durfeeke1/team33ME210Project/Report/index.html

# TEAM 33

# Team Name: 0 - 2 (Real Quick) ME210 Winter

## Project Overview

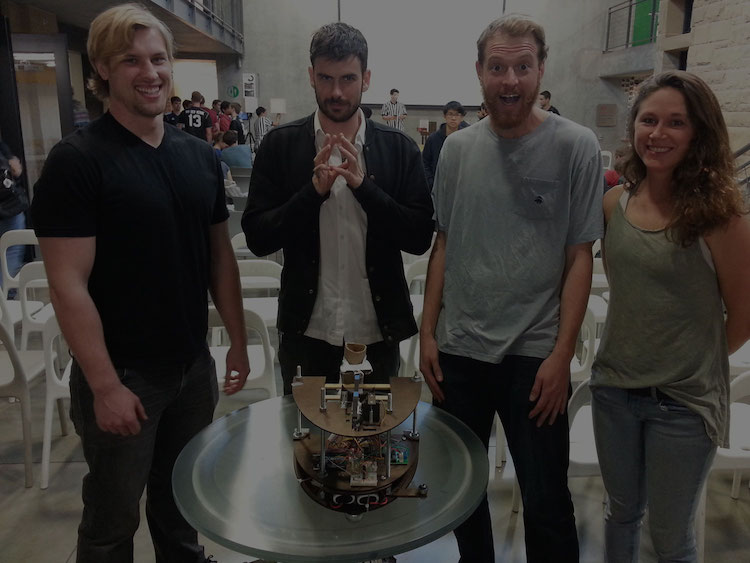
[picture p1: Report/img/teamPhoto.jpg]


Team Members: Kevin Durfee, Carey Smith, Ryan Wolff, Maria Malone

As the ME 210 Robot Project sat on our Winter Quarter horizon, Team 0 to 2 (Real Quick) pondered our overall strategy. While we wanted to put 100% effort into the project, we also valued our health and other classes. We deemed ourselves to be a “Shallow Grave” group – we wanted to do enough work to check off and learn a lot, but weren’t preparing ourselves to win the competition.

When the project was assigned we decided early on that we would not do beacon sensing, and instead we chose to use the tape on the board to align ourselves with the 1 point basket on our side of the court.

Here is our story.

## DrizzyBot / Cheff Curry - Sub Systems

### Bill Of Materials

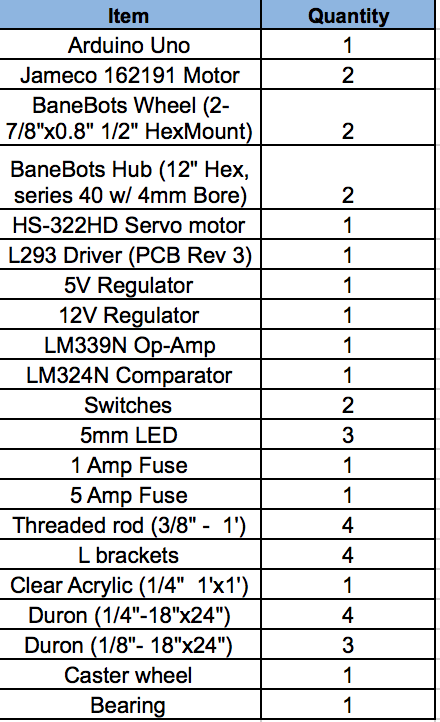
[picture p2: Report/img/BOM2.png]


## Mechanical Design

### Overall Chassis Design

We chose a body shape that we thought would be ideal to keep us out of corners yet still align us square on the wall behind us. However the radius of the nose of the body did render us useless in some corners when starting from certain positions on the court. A square bot, though, would not have kept us from getting stuck in corners either. Overall bot design could have been improved with a circular bot base. Implementing alignment bumpers similar to the ones currently on Drizzy Bot/Chef Curry would have still allowed a circular design to accurately line and square up on the wall.

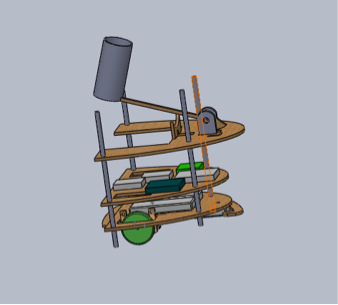
[picture p3: Report/img/cadSideView.png]


### Drive Train

The secure mounting of our motor to both the body of the bot and the wheels was crucial in order to get a reliable driving bot that wasn’t unstable or weak. Initially, we used two similar motor mounts on each side, each of which cradled the motor to keep it from falling. These two mounts were then fixed a distance apart using bolts and nuts. However, because it was difficult to get the precise tolerance in the motor mounts, there was just enough “slop” and freedom for the motors to move and shift within the mount. We then decided it would be best to create just one motor mount for each side, which bolted into the face of the motor and was then secured to the base of the bot through an L-bracket. This was a reliable method for motor stabilization, albeit not the most intricate or aesthetically pleasing. However, because it was a method that worked well, we decided to move forward with the construction of the rest of our bot.

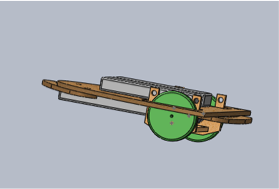
[picture p4: Report/img/cadBase.png]


### Tape Sensors

The mechanical design of our tape sensor setup was crucial to the successful functioning of the system as a whole. If the spacing of the sensors was slightly off, the accuracy of both tape sensing and following would be lower than it potentially could be. When using tape sensors, the spacing is crucial but so is the position of the tape sensors relative to the board. Because the tape sensors easily could pick up ambient light, the ideal height of the tip of the sensors was 1mm-4mm above the board. Additionally, the tip of the sensors needed to be as parallel to the board as possible. Because different times of day and conditions could easily affect the reading of the tape sensors, we wanted to have the freedom and ability to adjust the positioning of each tape sensor and the sensor platform as a whole. Therefore each sensor was mounted to its own individual backplate, which itself was secured to the tape sensor platform. The screw which attached each tape sensor to the backplate allowed for individual tape sensor height adjustment fairly easily. (Each tape sensor has an optimally sized slot for a 4-40 screw to be used for mounting). The platform height was adjustable using a double nut design. If tape sensors are used, we highly suggest using some sort of adjustable design, similar to what we used. This allows for fine-tuning of the physical tape sensing system for optimal readings and response.

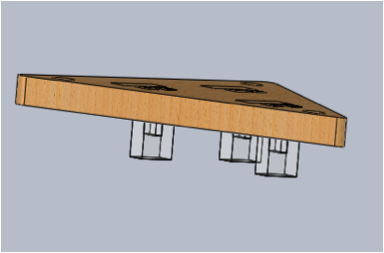
[picture p5: Report/img/cadTapeSide.png]
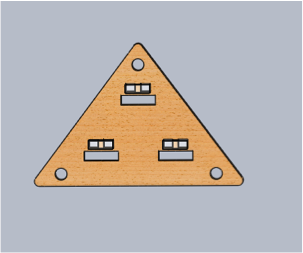
[picture p6: Report/img/cadTapeTop.png]
 

### Shooting Mechanism

Initially we couldn’t settle on an approach for scoring points. So we wavered between doing a shooter and dunker for a while. Because we lost a lot of time in limbo between the two, we decided that the most efficient use of our time was to implement a dunker in order check off. Our thoughts were to then perfect it when/if we had time. Because we worked to check off early, we used a dunk mechanism that ended up completing the challenge, yet was a visual eye sore. Our initial more intricate design implementing a natural hinge ended up being too heavy. While we liked the look and experiment with design much more, we knew that a more simple and light solution was needed to not overstress our servo motor.

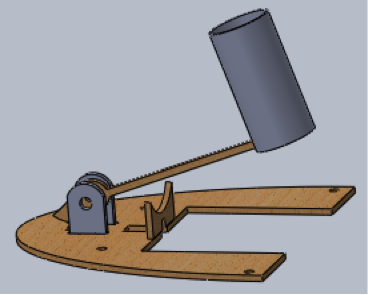
[picture p7: Report/img/cadTopLayer.png]


## Electrical Design

We broke the electrical system down into a few different circuits that were linked together.
Power Supply, Drive Train, Tape sensing, shooter mechanism

Generally our circuits were pretty solid. The biggest issue we encountered was when we swapped chasis. We had used the double sided tape on the bread boards to fix them to the first bot. When we removed them the tape completely destroyed our circuits!!! DON'T DO THAT.

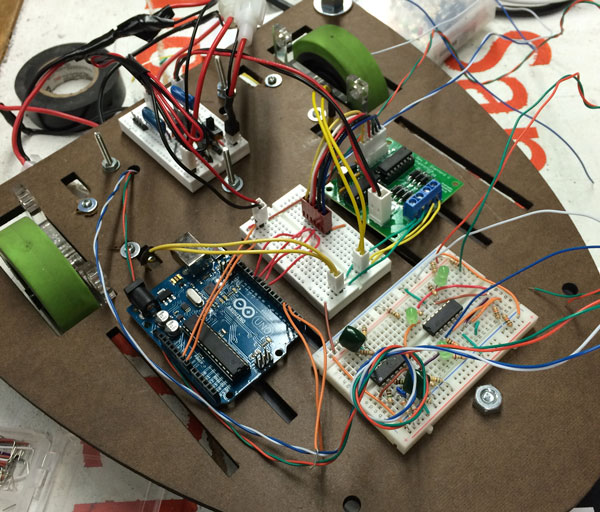
[picture p8: Report/img/circuits.JPG]


a photo of our circuits on the bot

### Schematics

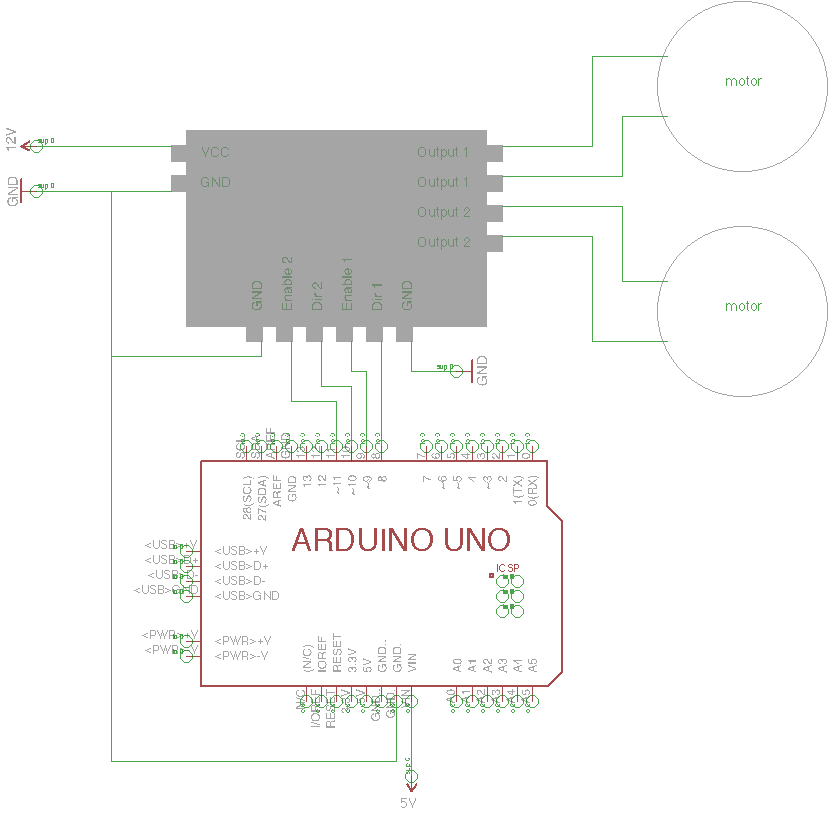
[picture p9: Report/img/DrivetrainSch.png]


drivetrain schematic

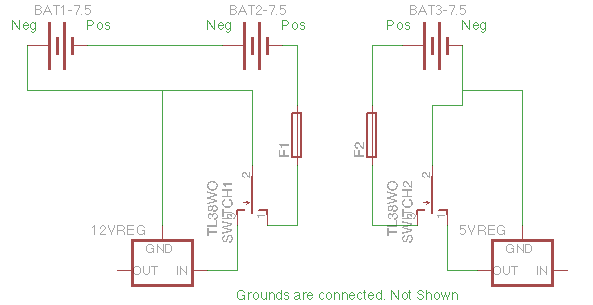
[picture p10: Report/img/PowerSch.png]


power supply schematic

## Tape Sensing

In our original design we attempted to create a digital input to the Arduino from each tape sensor. This design had three components to it.

First, we tied the anode of the photodiode to 5V and placed an 130 ohm resistor between its cathode and ground. This was done to ensure that the current going through the photodiode was large enough to be detected by the phototransistor but also not large enough to damage the component.

Equation 1: (Vdd-Vf)< 40ma => (5V-0V)/40ma < R => R > 125 ohms

Equation 2: (Vdd-Vf)> 20ma => (5V-1.7V)/20ma > R => R < 165 ohms

Second, we used an op-amp to amplify the signal. Here the positive input of the op-amp is tied to another op-amp that is generating a stable 2.5V. Using our ideal op-amp model this means that the op-amp will work as hard as it can to keep the negative input at 2.5V. As a result there is always a (5V-2.5V) = 2.5V drop across the phototransistor, which satisfies the forward voltage drop required for it to function properly. Since the current from the phototransistor cannot pass through the op-amp it can only travel through the resistor that connects the output to the negative input. As a result there is a voltage drop from the negative input to the output that is equal to the current from the photodiode multiplied by the resistor. Therefore our equation describing the output voltage as a function of the photodiode current is as follows:

Equation 3: Vo - V- = -IR => Vo = V- -IR => Vo = 2.5V - IR

We saw the voltage range from 2-2.5 when the tape sensor was about a quarter inch from the tape to .5 when the tape sensor was a quarter inch from the white board. We also tied an LED to the output of this stage, to give us visual confirmation that the circuit was generating the expected result. We used similar calculations to the ones used in stage 1 to determine that a 75 ohm resistor was required to limit the current through the diode. THIS WAS EXTREMELY HELPFUL! If you can use LED's to indicate what is happening in your circuits it makes it much easier to figure out what is going wrong while you are debugging.

The final stage of the circuit was meant to convert the signal from the op-amp to a logical 1 or 0 for the Arduino using a comparator with hysteresis. We eventually ended up dropping this stage of the circuit in our final design and used analoge input pins to read the output signal from the op-amp stage directly. This was done for a few reasons. First, the Arduino Uno only has 2 pins that can be configured to generate interrupts on rising or falling signals. Since our design uses 3 tape sensors, we couldn't take advantage of the speedy response time that interrupts offer. Second, the amount of ambient light in the lab changed the output of the op-amp stage enough that it was difficult to get the comparator stage to accurately determine if it should generate a 1 or 0. This could have been avoided if we had used an oscillator to generate the signal from our photodiode and then filtered out any signal from ambient light. In the end we decided the easiest thing to do would just be to handle the hysteresis and logic level conversion in software. I would recommend this to anyone. You only have two weeks and changing or debugging software is much easier than changing and debugging hardware.

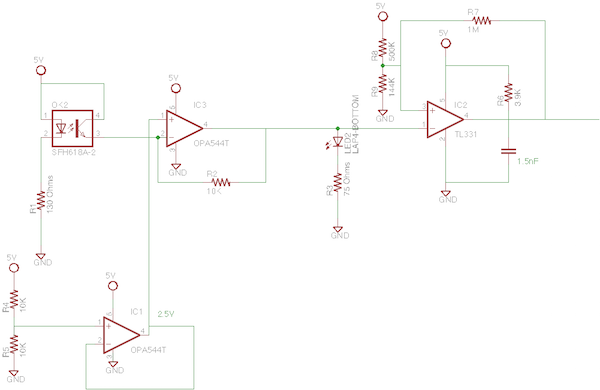
[picture p11: Report/img/firstTapeSensingCircuit.png]


Original Tape Sensing Circuit Design

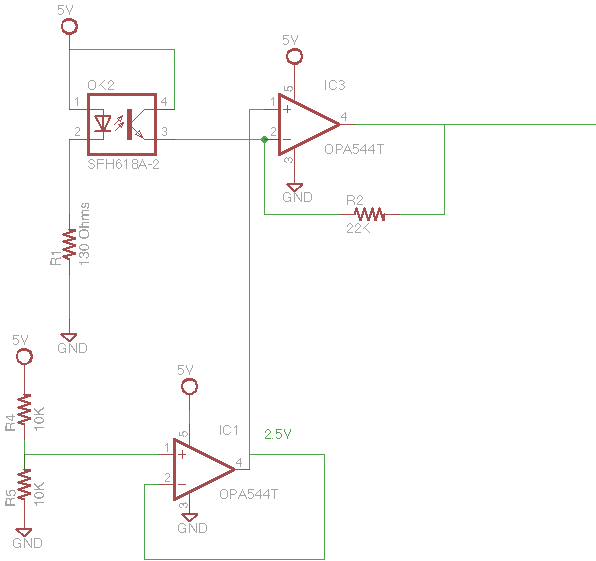
[picture p12: Report/img/finalTapeSensingCircuit.png]


Final Tape Sensing Circuit Design

## Software Design

Our software design can be broken down into a two levels. The first is the global state machine and the second is comprised of a mini state machine for each global state. This design is helpful because it segments the mini state machines from each other, making them easier to develop and debug independently. It also made it easy to loop the global state machine in order to make multiple passes at the hoop.

### Global State Machine

- Get Balls - used to bump the edge of the board and wait for balls to be loaded
- Align To Drive Straight - used to position the robot to follow the left wall to the end of the board
- Drive Straight - used to send the robot to the end of the board
- Tape Sensing - used to find the tape in front of the hoop and make a 90 degree turn
- Dunking - used to raise the servo and drop the balls in the hoop

### Sub State Machines:

Each of the sub state machines was implemented as a single function with a static variable used to keep track of the current state. I would recommend this as it hides the sub state machines state from the rest of the code. When the sub state machine has accomplished it's task it then changed the global state to move on to the next sub state machine.

## What we learned

We executed our plan but made changes along the way, the best practice we can recommend is to anticipate and prepare for unknown changes. The best way to do this is designing for testing. Build your components to be sturdy but flexible and provide feedback. The first mount for our tape sensors allowed us to adjust the distance between them. It was quick, flexible and we could immediately change the arrangement based on observations we wouldn’t have predicted.

Our tape sensors were arranged close together on the underside of the bot and very difficult to see which sensor was over tape at any time. We integrated LEDs into our tape sensing circuit that indicated when each tape sensor was reading Hi at any given moment. This helped in most cases but as we progressed our states were dependent the previous tape sensor reading as well as the most recent. To solve this issue, we arranged the arduino to allow for “tethered” testing. The serial monitor displayed which state our bot was in and anytime the sensors changed. With this information could determine the exact path the bot and sensors took over the tape and how to correct it. We designed and built many of the components in parallel but upon integration ran into multiple problems (Here’s a tip - using the Servo library disables the PWM functionality of pins 9 & 10, so don’t use them to run your motors). Swapping chassis also changed the weight distribution, negating the time spent calibrating the motors on the first version.

The language and naming conventions should also be made clear early on. Things can get confusing when you start turning, moving in reverse, increase the power of the right motor to turn left, etc. Like in theatre, they have a convention of stage right/left, discuss the behavior of your bot in a consistent manner and comment your code accordingly.

Remember to step back and look at how everything works together. There are many solutions to every problem. If you are having trouble getting results with an electrical component like the tape sensors, think about a software or mechanical solution. You could change the hysteresis or change where they are mounted or you could change another part of the bot entirely. We modified the shape of our bot and used its geometry to orient ourselves perpendicular to the walls. This allowed for a consistent approach angle to the tape which was crucial for our alignment with the basket. Don’t underestimate the physical world! Cut out a model of your bot and walk it around the game board, walk it around, take it through your states step by step.
