durfeeke1/team33ME210Project/Report/img/BotCollage.jpg

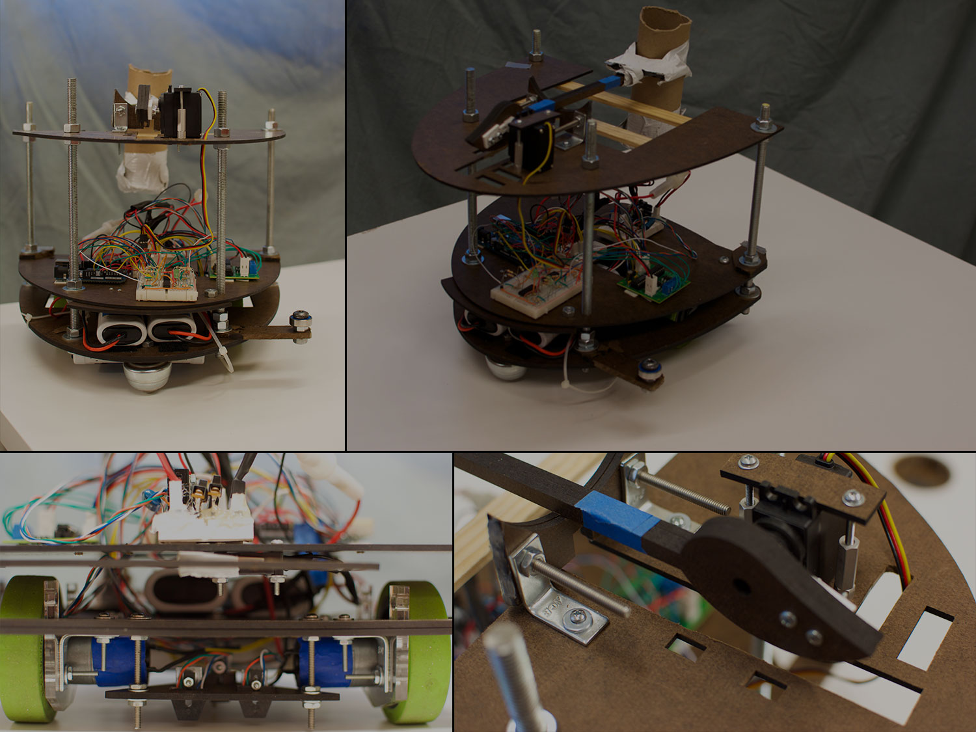
Report/img/BotCollage.jpg
