durfeeke1/team33ME210Project/Report/img/Hammer.png

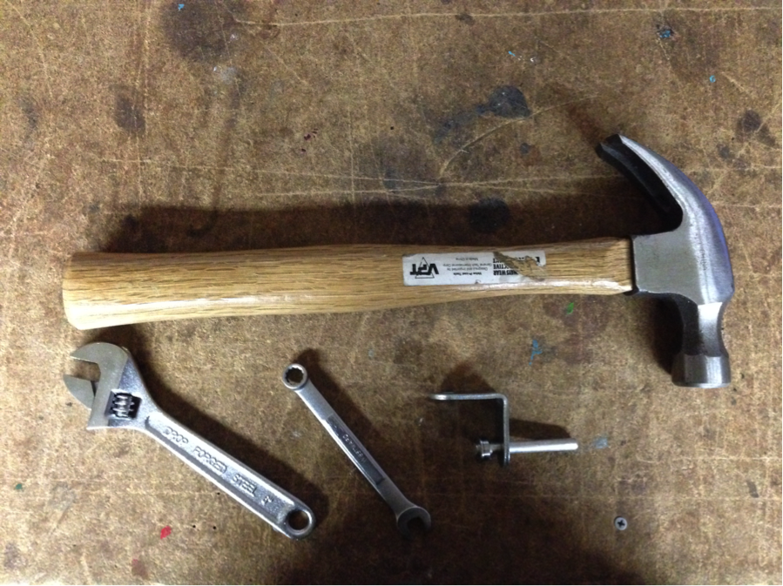
Report/img/Hammer.png
