durfeeke1/team33ME210Project/Report/img/BOM.png

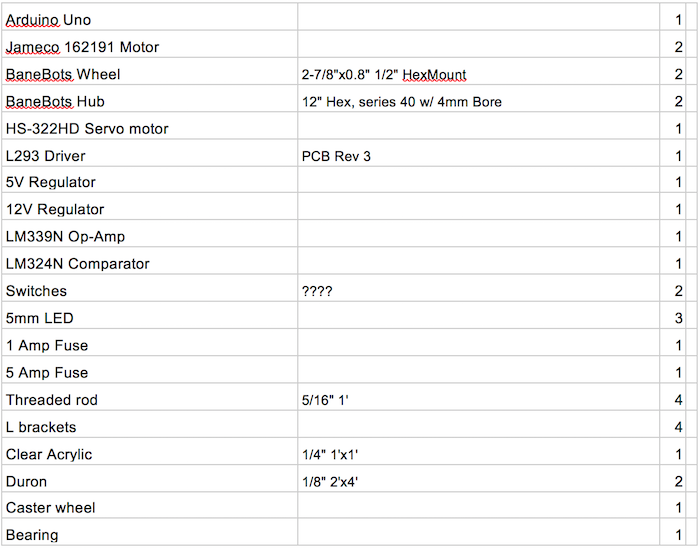
Report/img/BOM.png
