durfeeke1/team33ME210Project/Report/img/tapeTesting.png

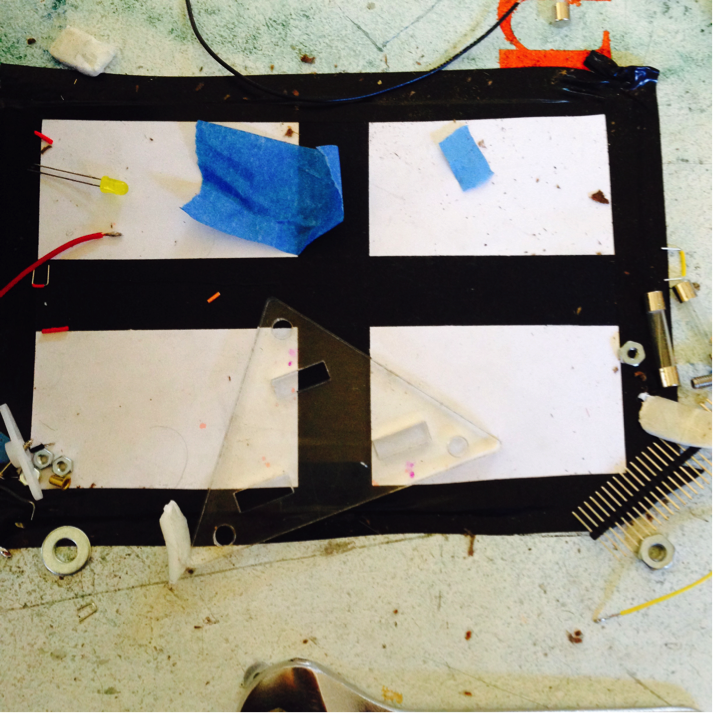
Report/img/tapeTesting.png
