durfeeke1/team33ME210Project/bot/Motorlib.h

typedef enum {
   OK_SPEED, ERR_BADSPEED
} RoachReturn_t;

void MotorInit(void);
RoachReturn_t LeftMtrSpeed(char newSpeed);
RoachReturn_t RightMtrSpeed(char newSpeed);
unsigned int LightLevel(void);
unsigned char ReadBumpers(void);

void SET_SHARED_BYTE_TO(unsigned char);
unsigned char GET_SHARED_BYTE(void);
void SET_SHARED_WORD_TO(unsigned int);
unsigned int GET_SHARED_WORD(void);
