durfeeke1/team33ME210Project/(commit log)

2015-02-25 added some interrupt handlers for tape sensors
2015-02-27 Motor test commit 02/21/15
2015-03-02 added framework for getting balls
2015-03-03 added our own motorlib that goes 0-100 instead of 0-10
2015-03-04 fixed bug in transition to dunk
    [bot.ino]
2015-03-15 added tape sensing explaination and schematics
